cgarcia2097/DIY-8-Button-Keypad/README.md

# DIY-8-Button-Keypad
Repository for the 8-button keypad project
