cgarcia2097/DIY-8-Button-Keypad/3D Case Files/8-Key/Tub.stl

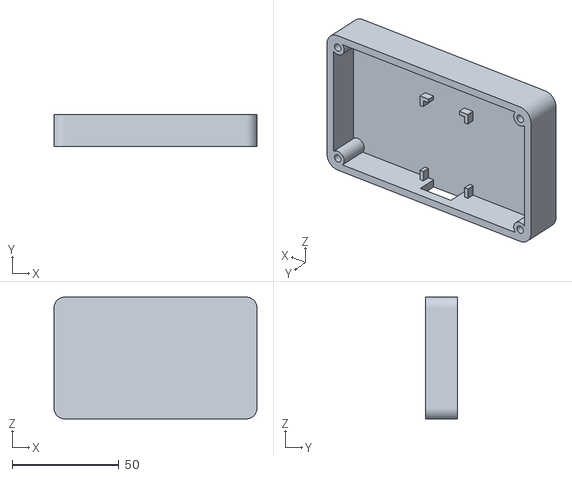
[picture p1: CAD file, 2018-08-02]
3D Case Files/8-Key/Tub.stl
95.0 x 15.0 x 57.0
