cgarcia2097/DIY-8-Button-Keypad/3D Case Files/Sanwa KB/Sanwa Bottom.stl

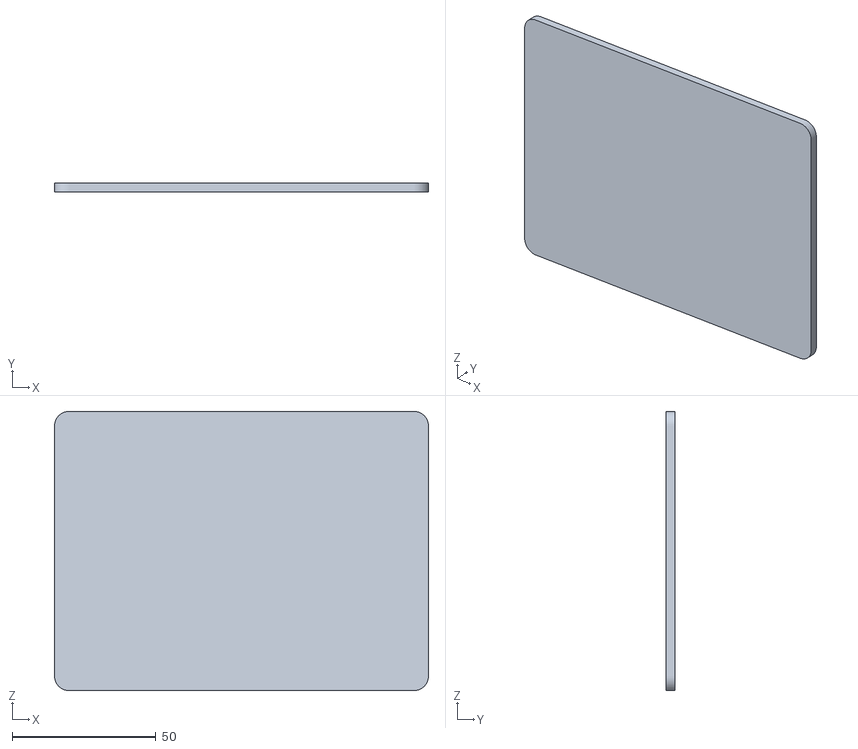
[picture p2: CAD file, 2019-02-10]
3D Case Files/Sanwa KB/Sanwa Bottom.stl
130.0 x 3.00 x 97.0
