cgarcia2097/DIY-8-Button-Keypad/3D Case Files/8-Key/Plate.stl

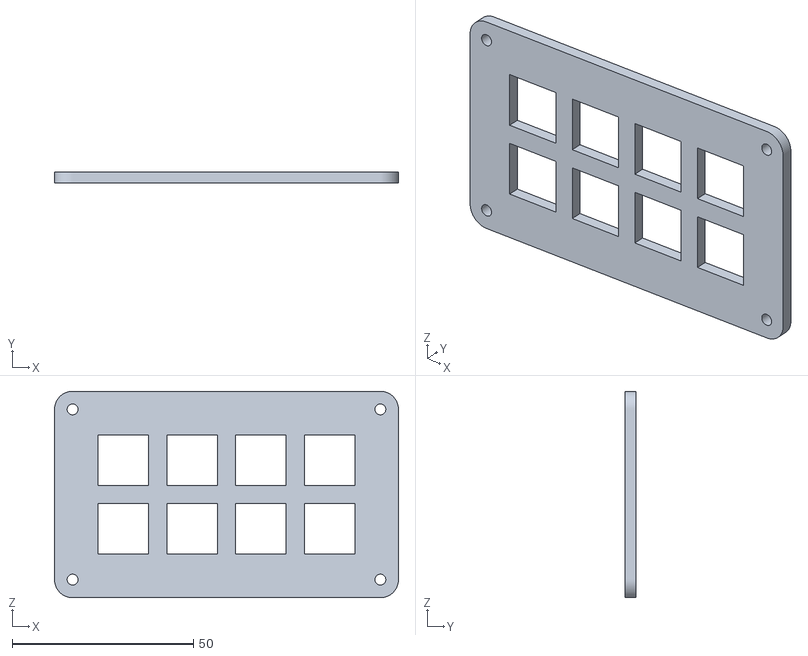
[picture p3: CAD file, 2018-08-02]
3D Case Files/8-Key/Plate.stl
95.0 x 3.00 x 57.0
