cgarcia2097/DIY-8-Button-Keypad/3D Case Files/Sanwa KB/Sanwa Wall.stl

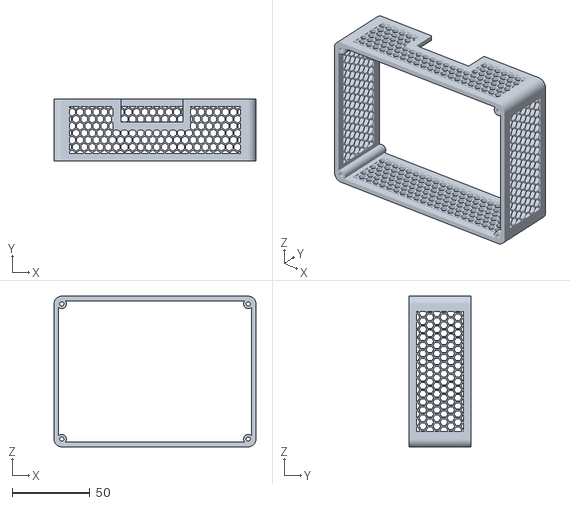
[picture p4: CAD file, 2019-02-10]
3D Case Files/Sanwa KB/Sanwa Wall.stl
130.0 x 40.0 x 97.0
