cgarcia2097/DIY-8-Button-Keypad/(commit log)

2018-08-02 Add files via upload
    3D Files required to create the 8-button design from a 3D Printer.
    [Plate.stl, Tub.stl]
2019-02-10 Reorganized files and created V2 version of the code
    [Plate.stl, Sanwa Bottom.stl, Sanwa Switch.stl, Sanwa Wall.stl, Tub.stl]
2019-02-10 deleting more stuff
    [Plate.stl, Tub.stl]
2019-02-10 Organizing code and files
    [Plate.stl, Sanwa Bottom.stl, Sanwa Switch.stl, Sanwa Wall.stl, Tub.stl]
2019-02-10 More stuff deleted
    [Plate.stl, Sanwa Bottom.stl, Sanwa Switch.stl, Sanwa Wall.stl, Tub.stl]
2019-02-10 Organizing some stuff
    [Plate.stl, Sanwa Bottom.stl, Sanwa Switch.stl, Sanwa Wall.stl, Tub.stl]
2019-02-10 More stuff gone...
    [Sanwa Bottom.stl, Sanwa Switch.stl, Sanwa Wall.stl]
2019-02-10 More cleanup
    [Plate.stl, Tub.stl]
2019-02-10 Organizing stuff
    [Plate.stl, Sanwa Bottom.stl, Sanwa Switch.stl, Sanwa Wall.stl, Tub.stl]
